amir684/esp8266-gps-logger-spiflash/docs/Front.jpg

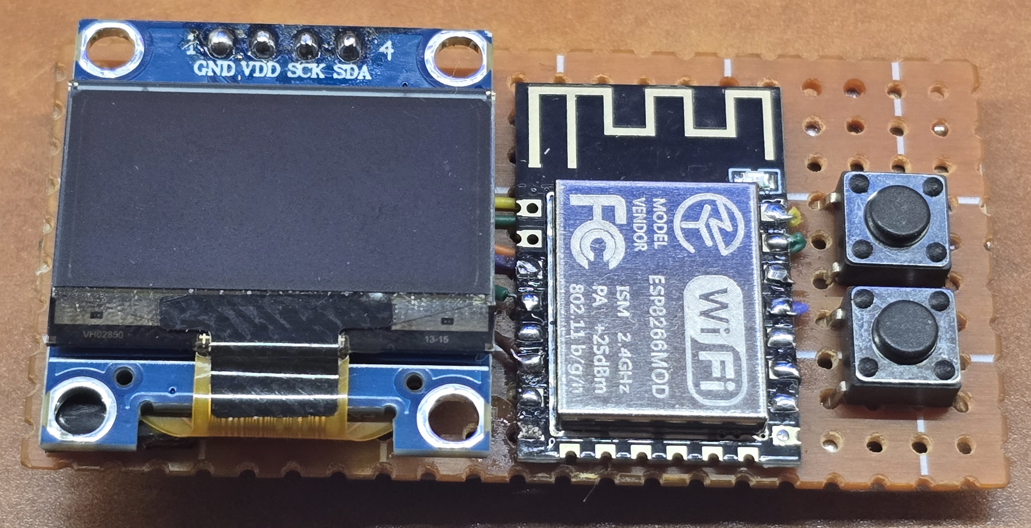
docs/Front.jpg
