amir684/esp8266-gps-logger-spiflash/(commit log)

2026-01-31 Rename צילום מסך 2026-01-31 223135.png to web.png
2026-02-15 Fix watchdog reset on large KML file downloads
    Issue: ESP8266 was resetting when downloading large KML files due to
    watchdog timeout during the two-pass file processing.
    Solution:
    - Add aggressive watchdog feeding with ESP.wdtFeed() and yield()
    - Feed watchdog every 50 GPS points OR every 1 second (whichever comes first)
    - Applied to both PASS 1 (finding vmax) and PASS 2 (generating KML)
    This ensures the watchdog is fed at least every 1-2 seconds even with
    large log files, preventing reset during download.
    [ESP8266_GPSlogger_SPIflashV2.0_withKML.ino]
